pipebenitezpb1/RobotFace/web/img/prueba_mdf.jpg

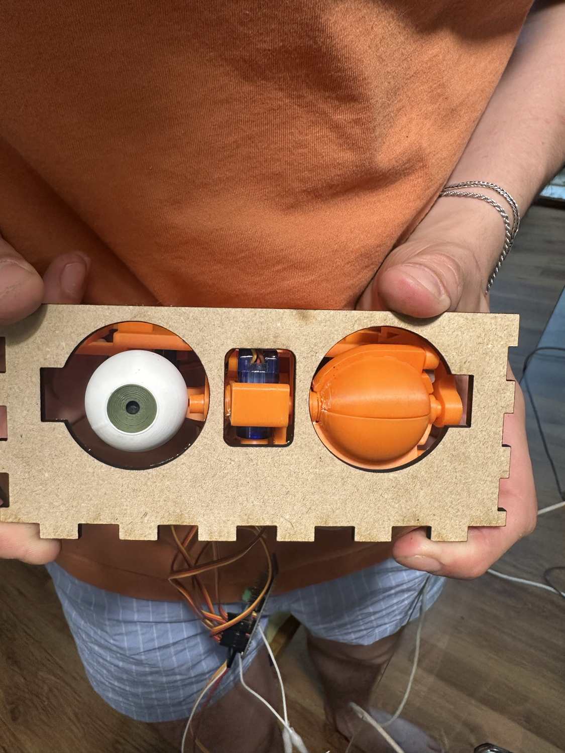
web/img/prueba_mdf.jpg
