pipebenitezpb1/RobotFace/web/img/proceso_prueba_notebook.jpg

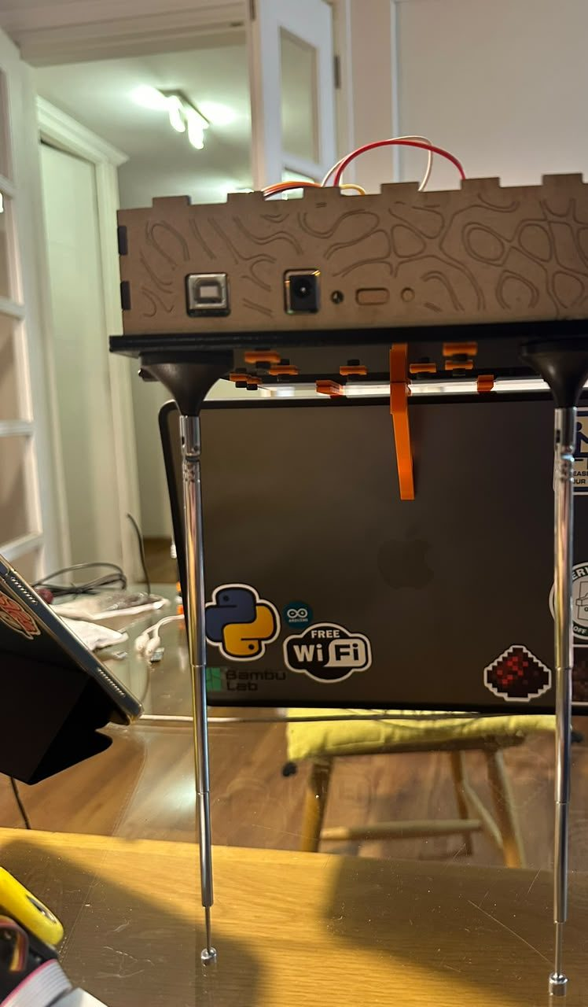
web/img/proceso_prueba_notebook.jpg
