pipebenitezpb1/RobotFace/conocimiento_escuela.ejemplo.md

# Lo que sabe el robot de su escuela (ejemplo)
Copia este archivo como `conocimiento_escuela.md` y completa con información pública del equipo
de tu escuela. hablar.py lo agrega a lo que sabe Claude. No lo subas a internet si trae datos
personales que las personas no publicaron.

## Autoridades
- Nombre Apellido: cargo. Estudios.

## Profesores
- Nombre Apellido: lo que enseña o estudió.
