pipebenitezpb1/RobotFace/cabeza/renders/base_acrilico.png

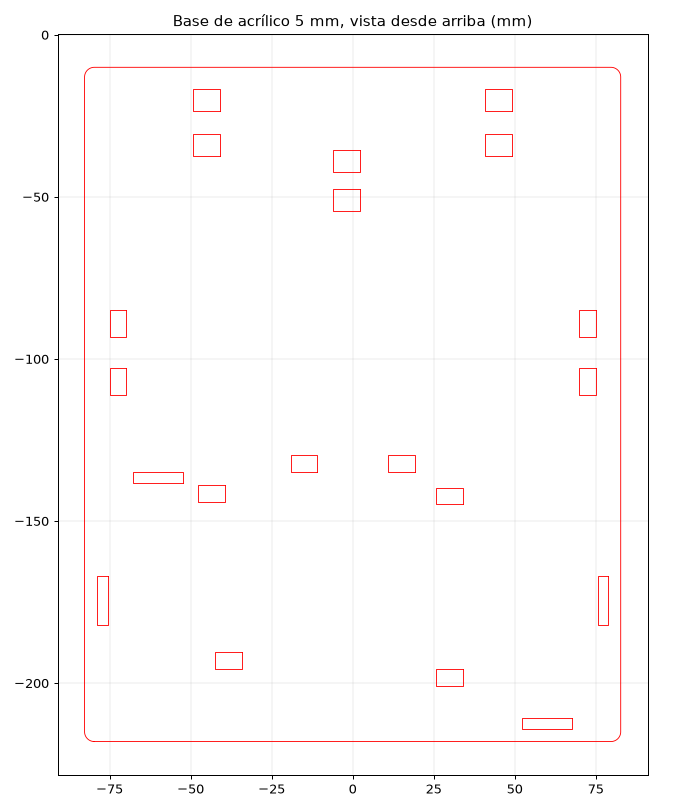
cabeza/renders/base_acrilico.png
