pipebenitezpb1/RobotFace/cabeza/renders/bocas_emociones.png

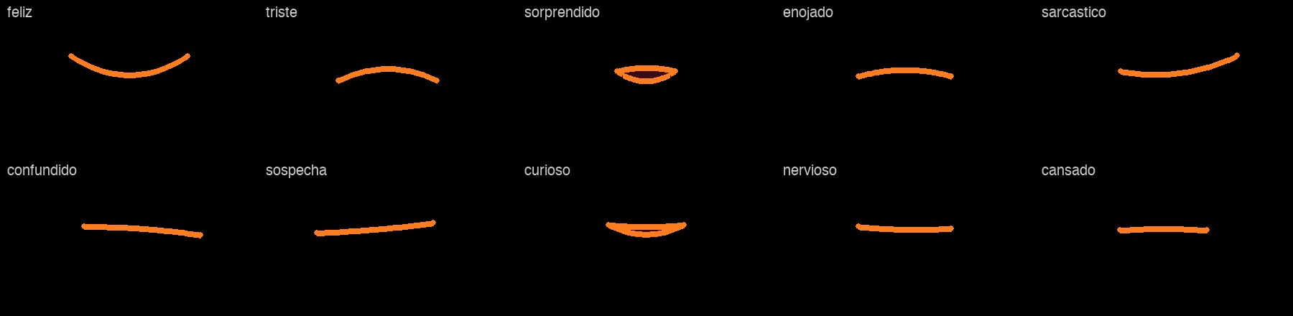
cabeza/renders/bocas_emociones.png
