pipebenitezpb1/RobotFace/cabeza/renders/caja_mdf3.png

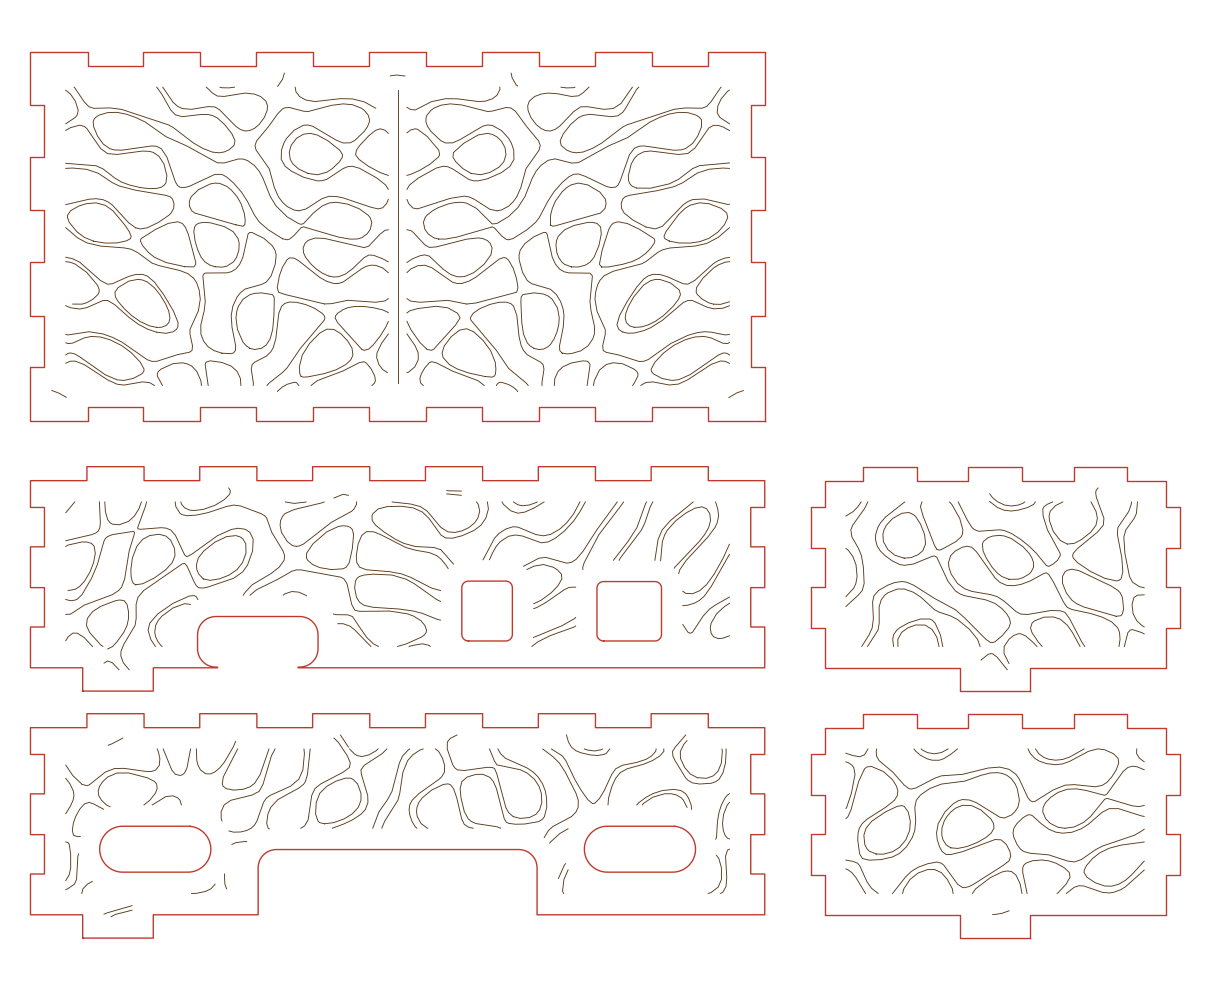
cabeza/renders/caja_mdf3.png
