pipebenitezpb1/RobotFace/cabeza/renders/capsula_usbc.png

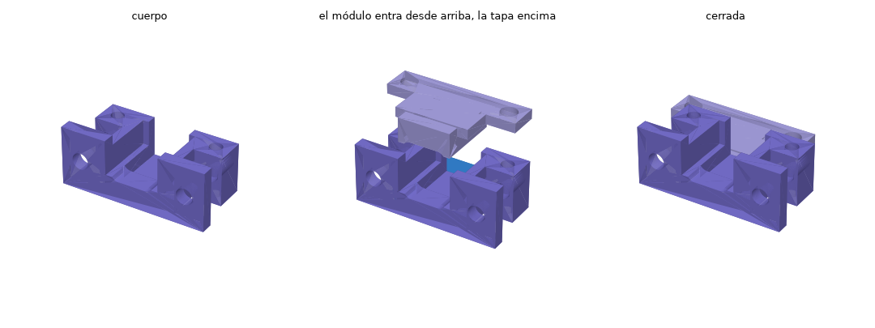
cabeza/renders/capsula_usbc.png
