pipebenitezpb1/RobotFace/cabeza/renders/capsula_usbc_frente.png

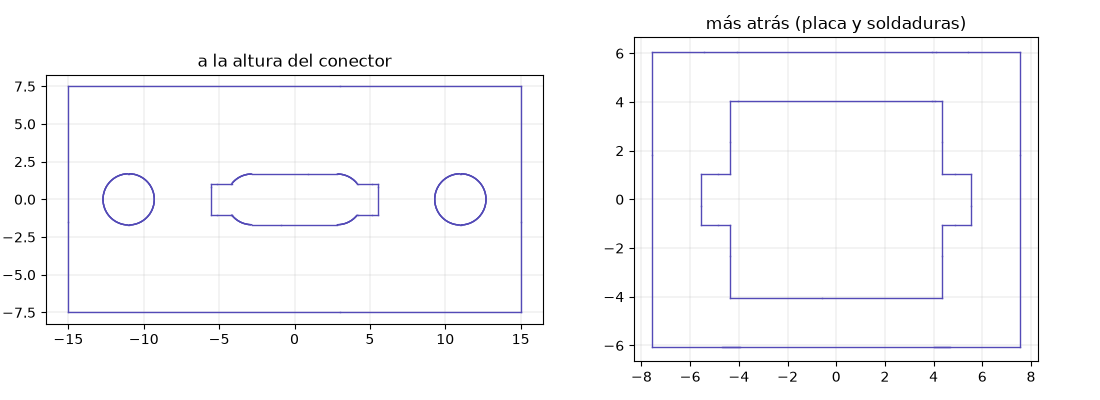
cabeza/renders/capsula_usbc_frente.png
