pipebenitezpb1/RobotFace/cabeza/renders/mapa_ranuras.png

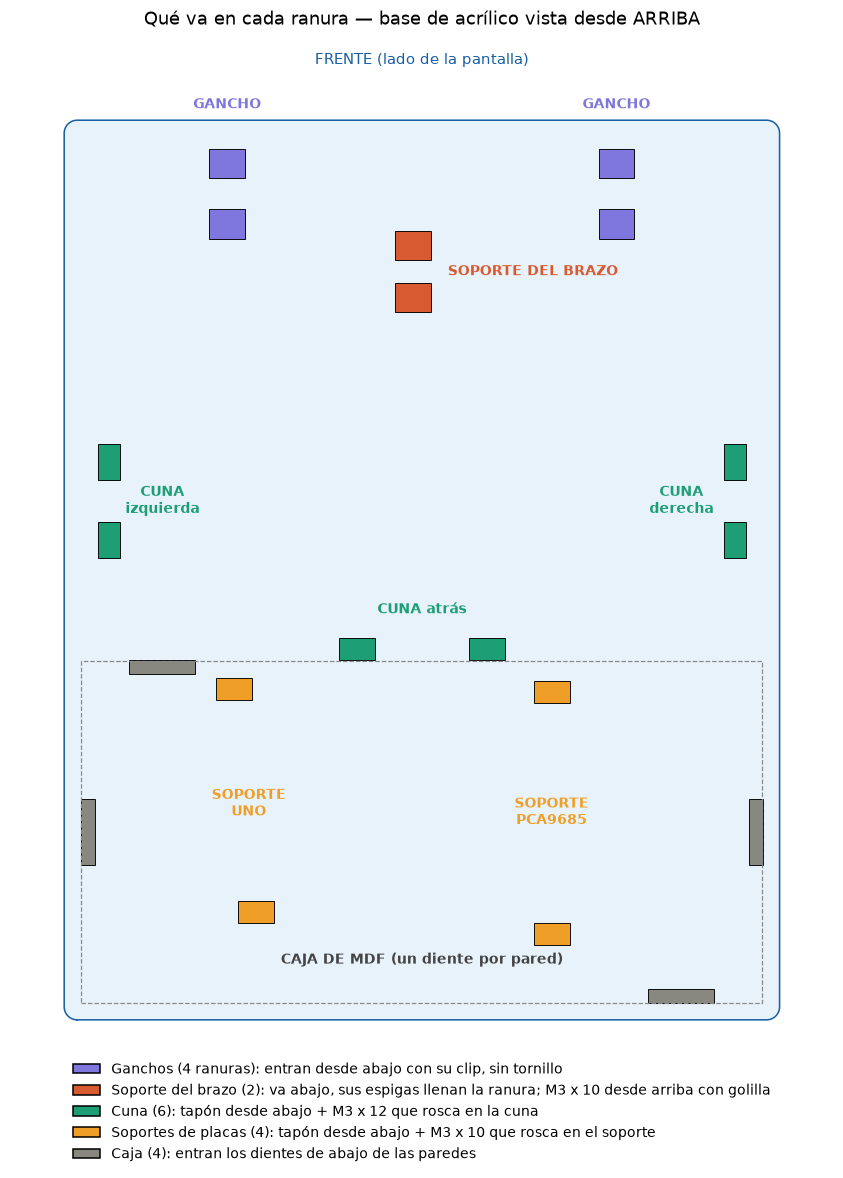
cabeza/renders/mapa_ranuras.png
