pipebenitezpb1/RobotFace/cabeza/renders/pata_lateral.png

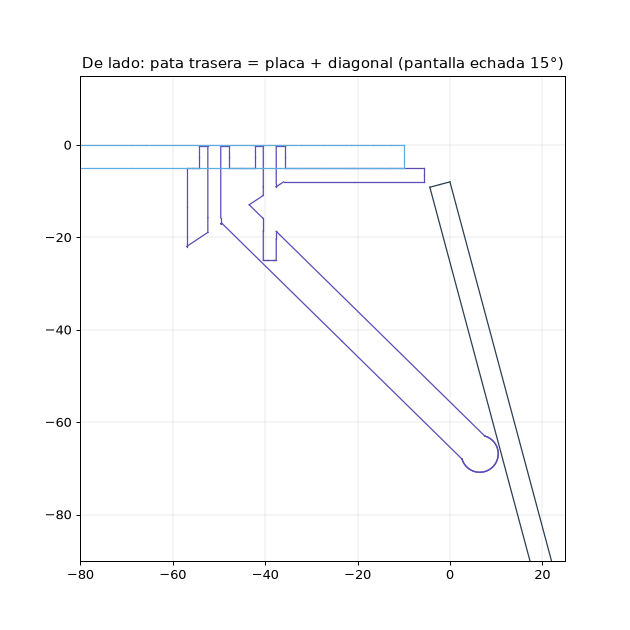
cabeza/renders/pata_lateral.png
