pipebenitezpb1/RobotFace/cabeza/renders/pata_mesa.png

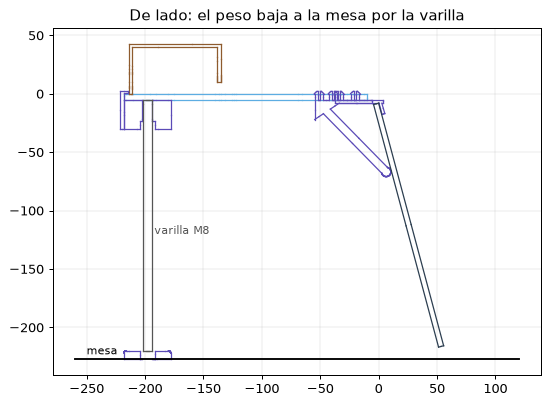
cabeza/renders/pata_mesa.png
