pipebenitezpb1/RobotFace/cabeza/renders/soporte_uno.png

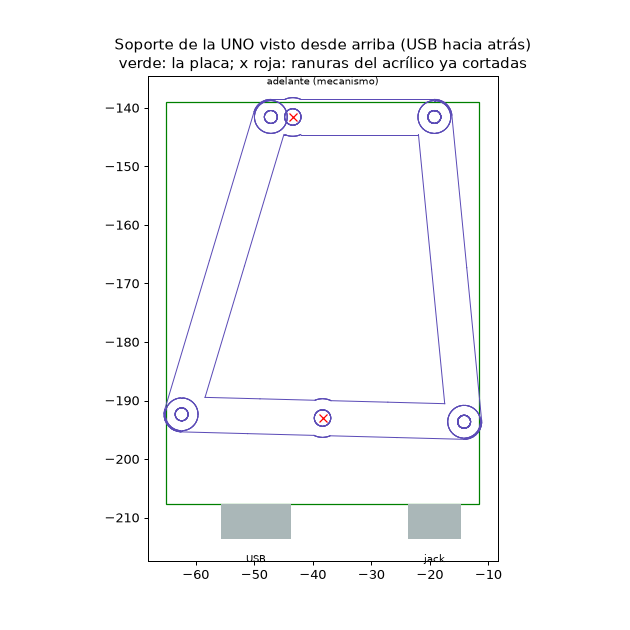
cabeza/renders/soporte_uno.png
