pipebenitezpb1/RobotFace/cabeza/renders/vista.png

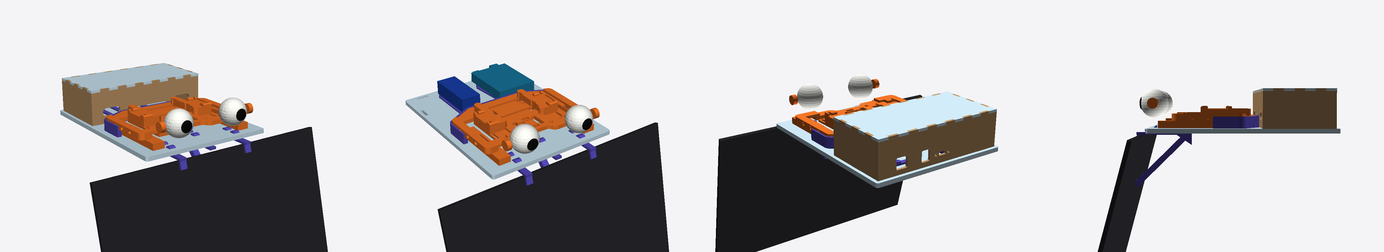
cabeza/renders/vista.png
