pipebenitezpb1/RobotFace/web/img/arriba.jpg

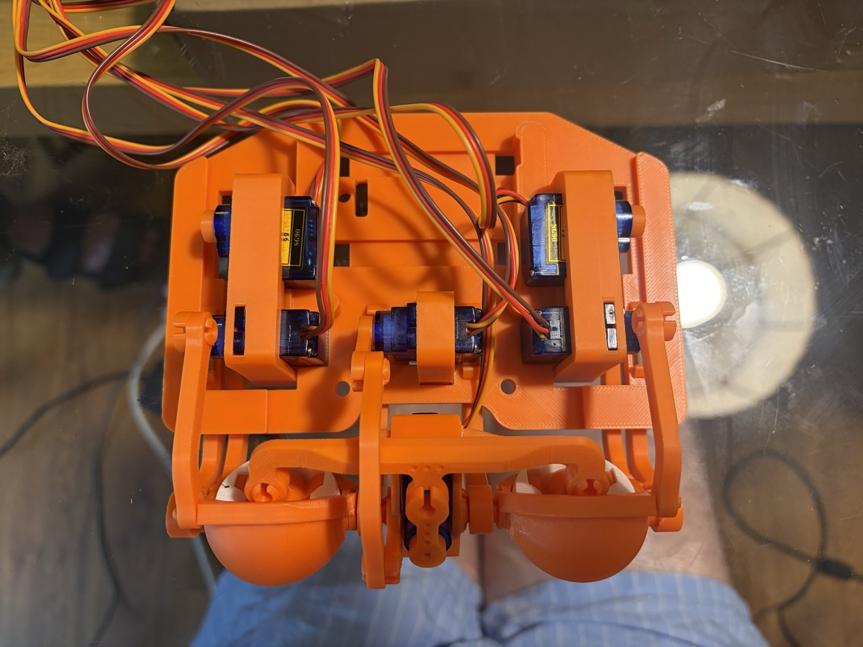
web/img/arriba.jpg
