pipebenitezpb1/RobotFace/web/img/atras.jpg

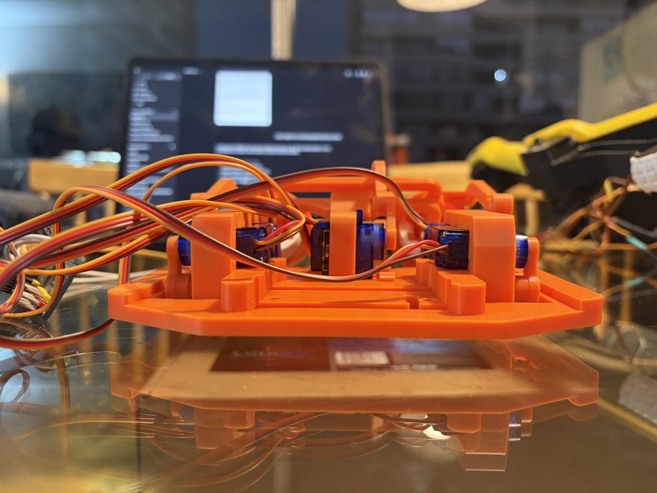
web/img/atras.jpg
