pipebenitezpb1/RobotFace/web/img/base.jpg

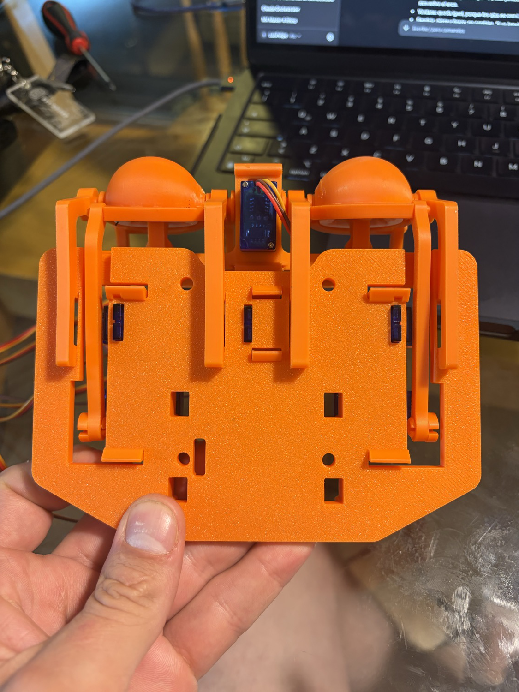
web/img/base.jpg
