pipebenitezpb1/RobotFace/web/img/boceto.jpg

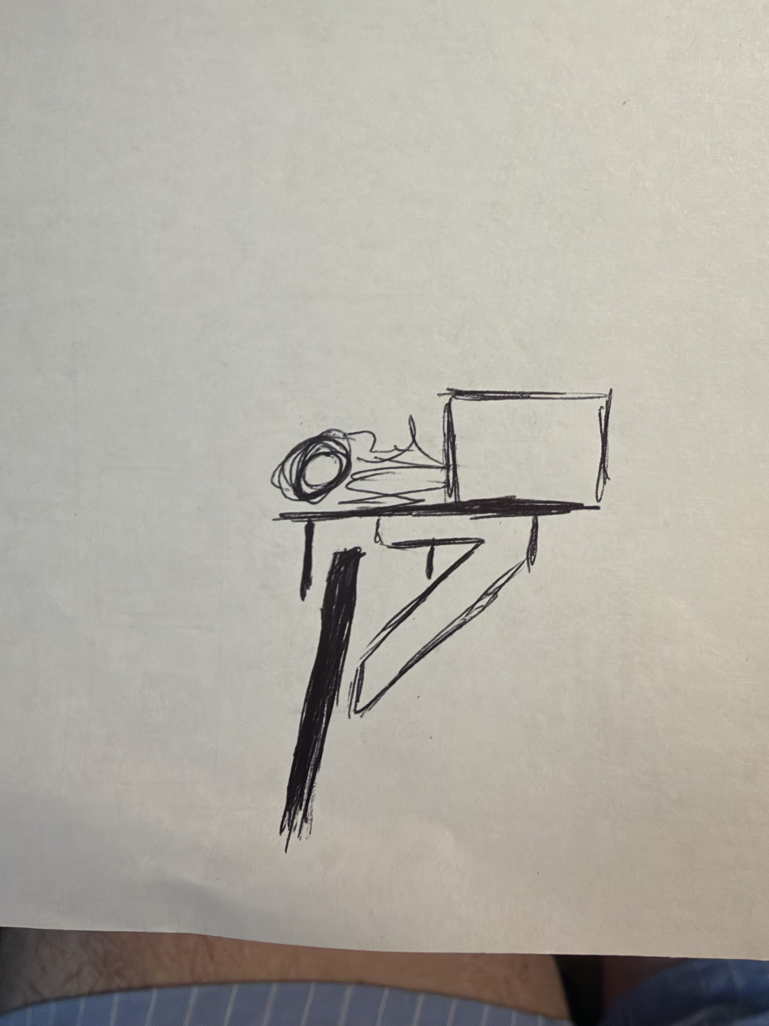
web/img/boceto.jpg
