pipebenitezpb1/RobotFace/web/img/estudio_arriba.jpg

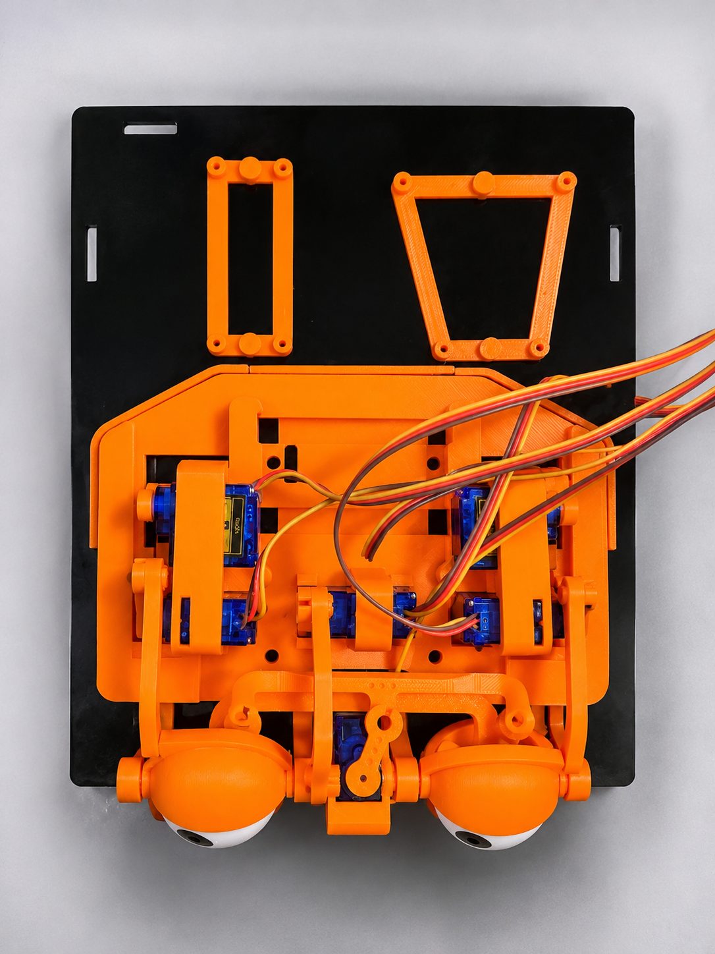
web/img/estudio_arriba.jpg
