pipebenitezpb1/RobotFace/web/img/estudio_arriba_arduino.jpg

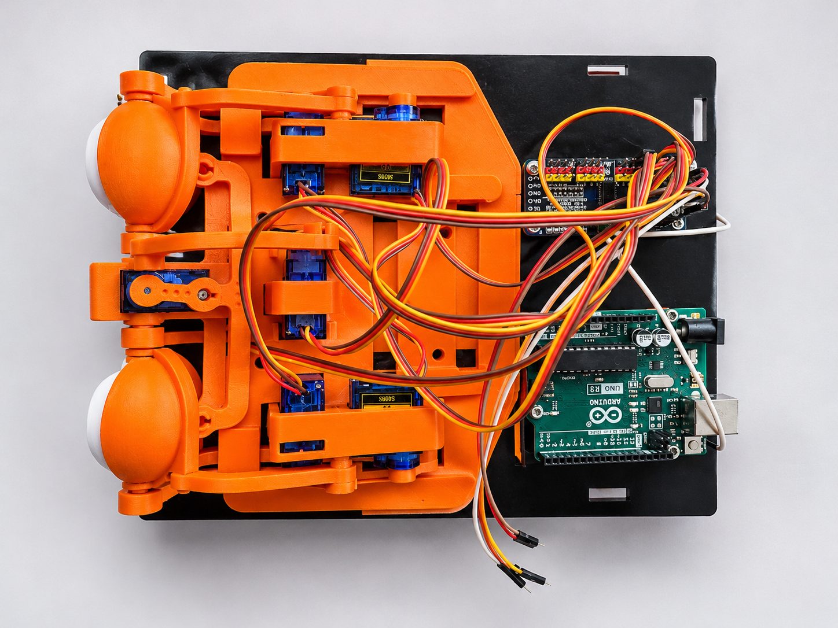
web/img/estudio_arriba_arduino.jpg
