pipebenitezpb1/RobotFace/web/img/estudio_frente_mdf.jpg

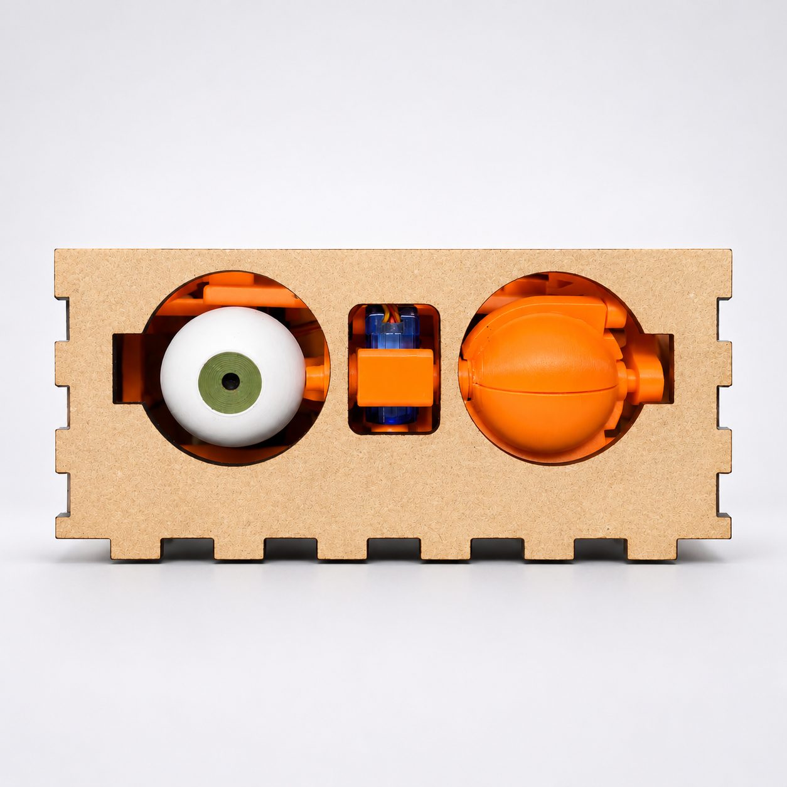
web/img/estudio_frente_mdf.jpg
