pipebenitezpb1/RobotFace/web/img/estudio_lado.jpg

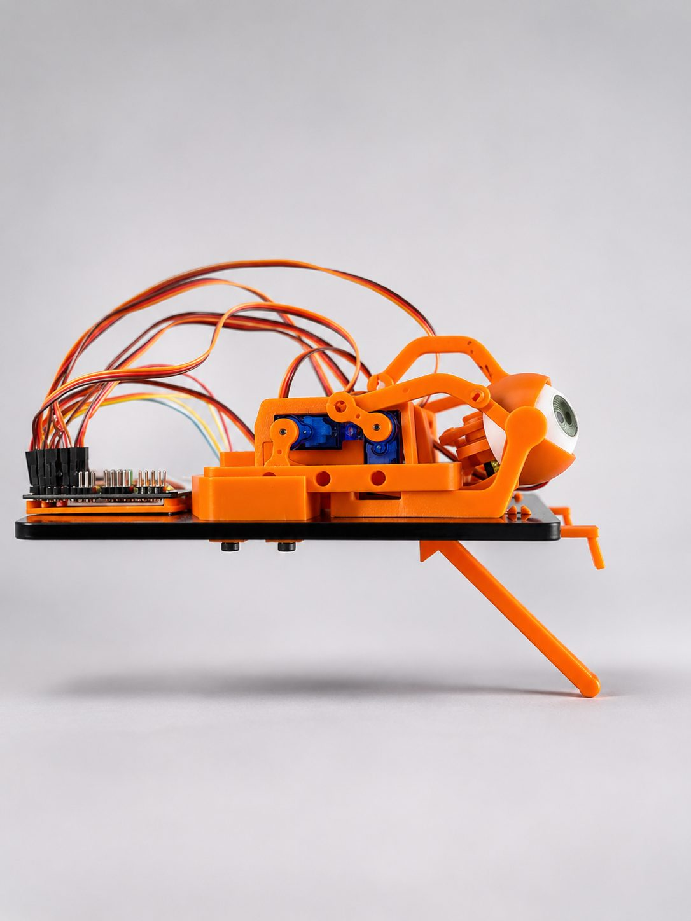
web/img/estudio_lado.jpg
