pipebenitezpb1/RobotFace/web/img/estudio_mecanismo.jpg

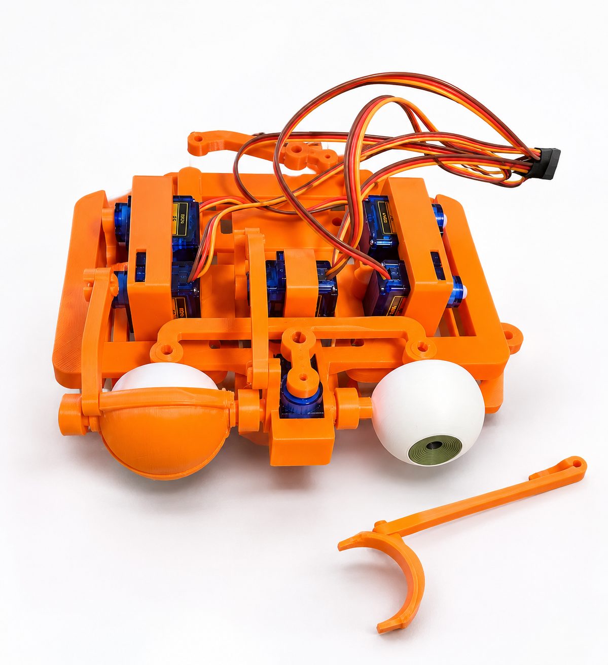
web/img/estudio_mecanismo.jpg
