pipebenitezpb1/RobotFace/web/img/estudio_tres_cuartos.jpg

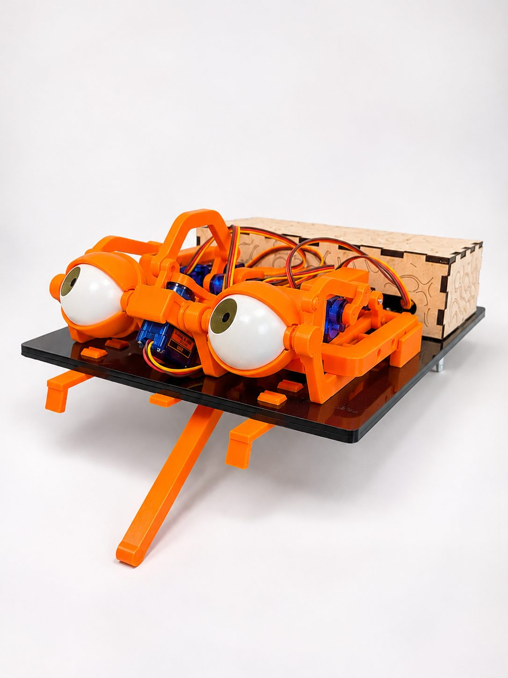
web/img/estudio_tres_cuartos.jpg
