pipebenitezpb1/RobotFace/web/img/frente.jpg

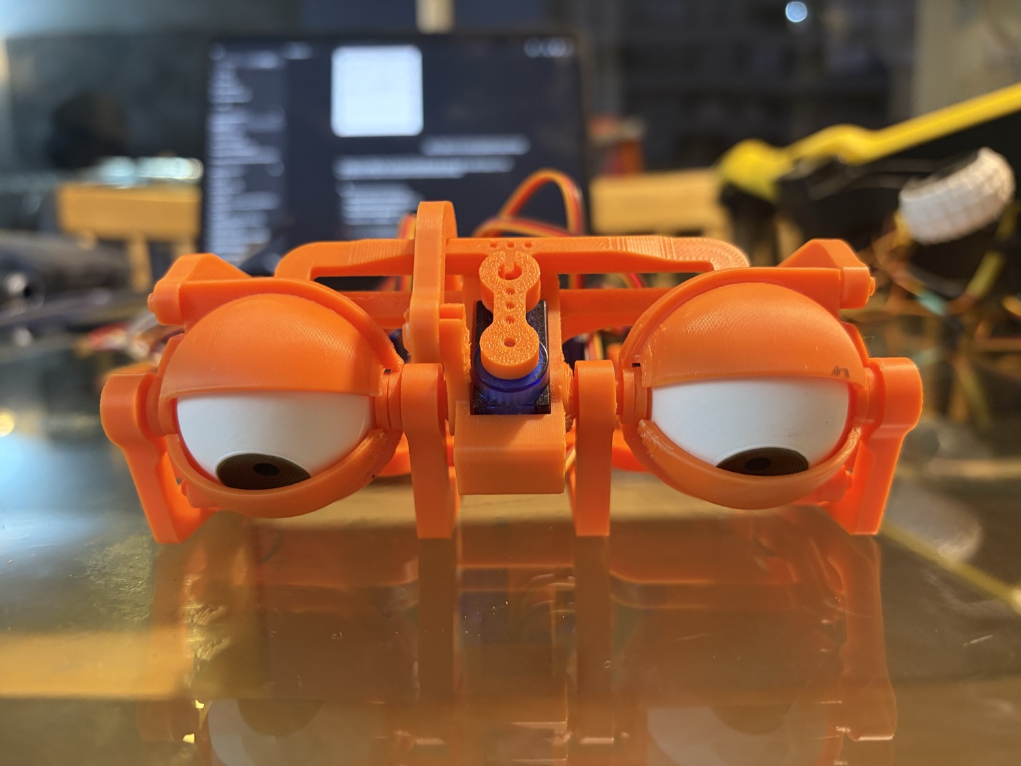
web/img/frente.jpg
