pipebenitezpb1/RobotFace/web/img/lado.jpg

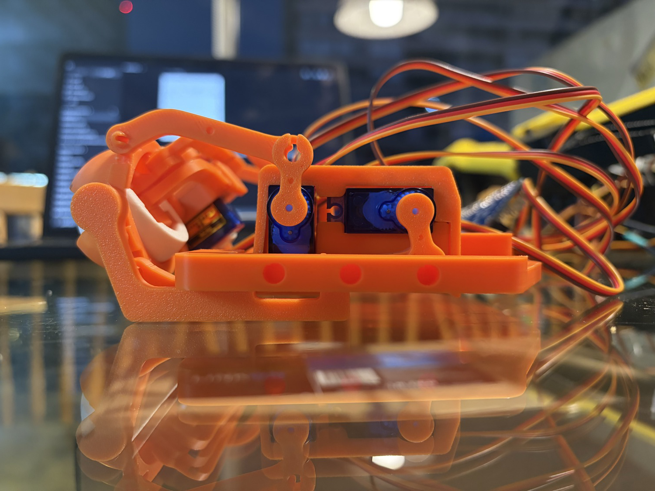
web/img/lado.jpg
