pipebenitezpb1/RobotFace/web/img/proceso_caja_abierta.jpg

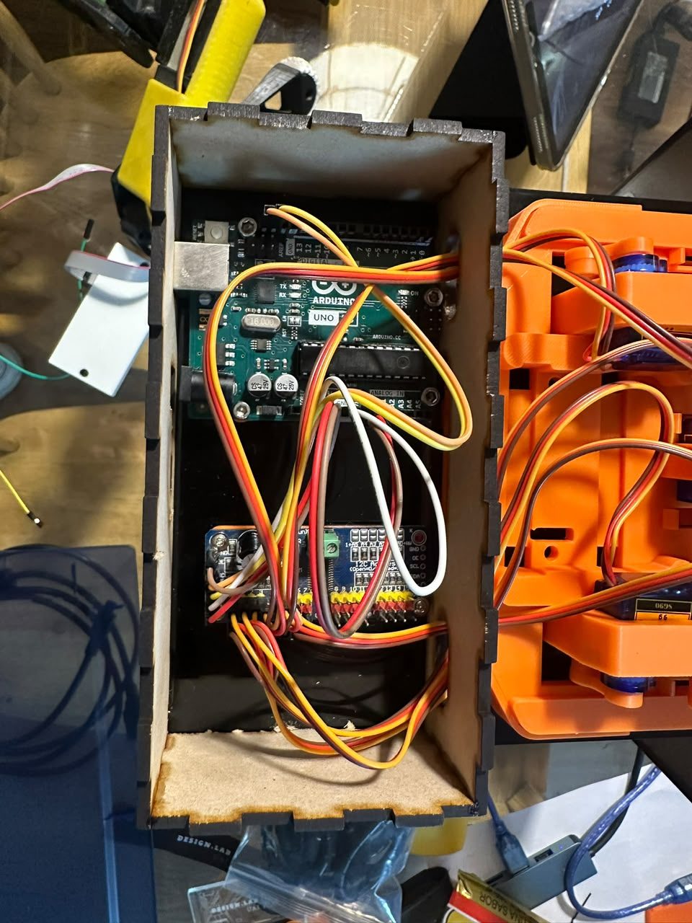
web/img/proceso_caja_abierta.jpg
