pipebenitezpb1/RobotFace/web/img/proceso_caja_cerebro.jpg

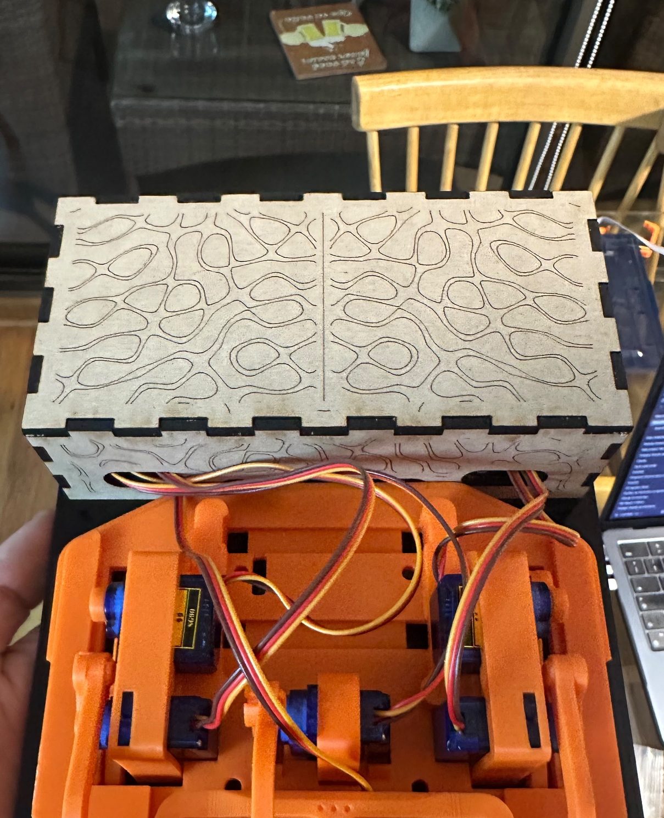
web/img/proceso_caja_cerebro.jpg
