pipebenitezpb1/RobotFace/web/img/proceso_electronica.jpg

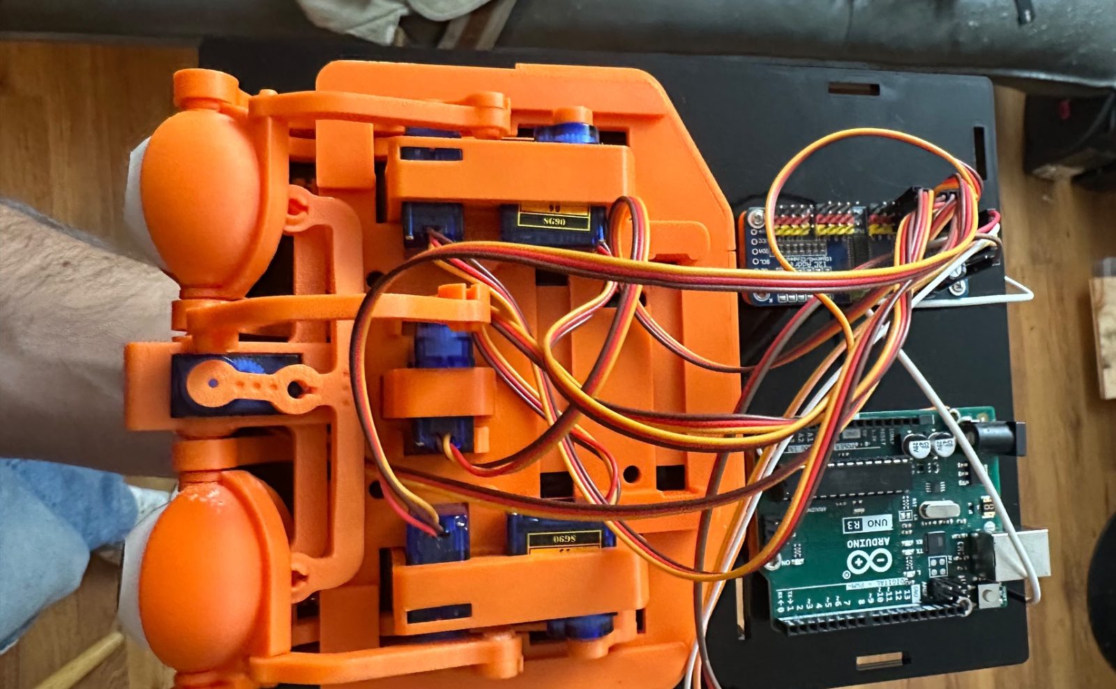
web/img/proceso_electronica.jpg
