pipebenitezpb1/RobotFace/web/img/proceso_frente.jpg

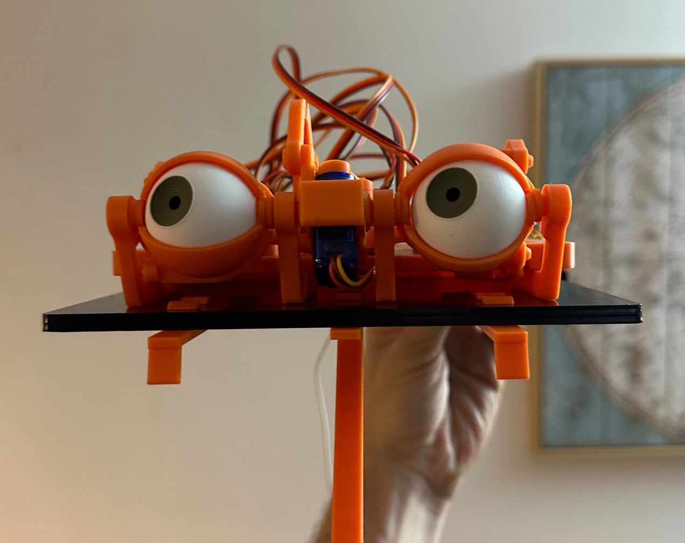
web/img/proceso_frente.jpg
