pipebenitezpb1/RobotFace/web/img/proceso_lado.jpg

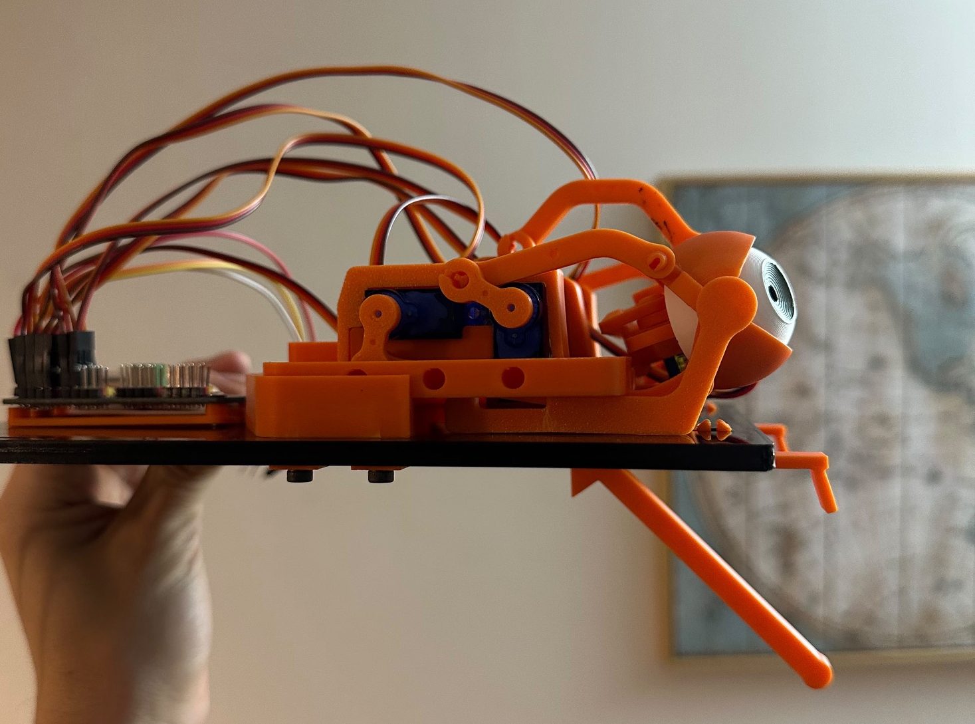
web/img/proceso_lado.jpg
