pipebenitezpb1/RobotFace/web/img/proceso_soportes.jpg

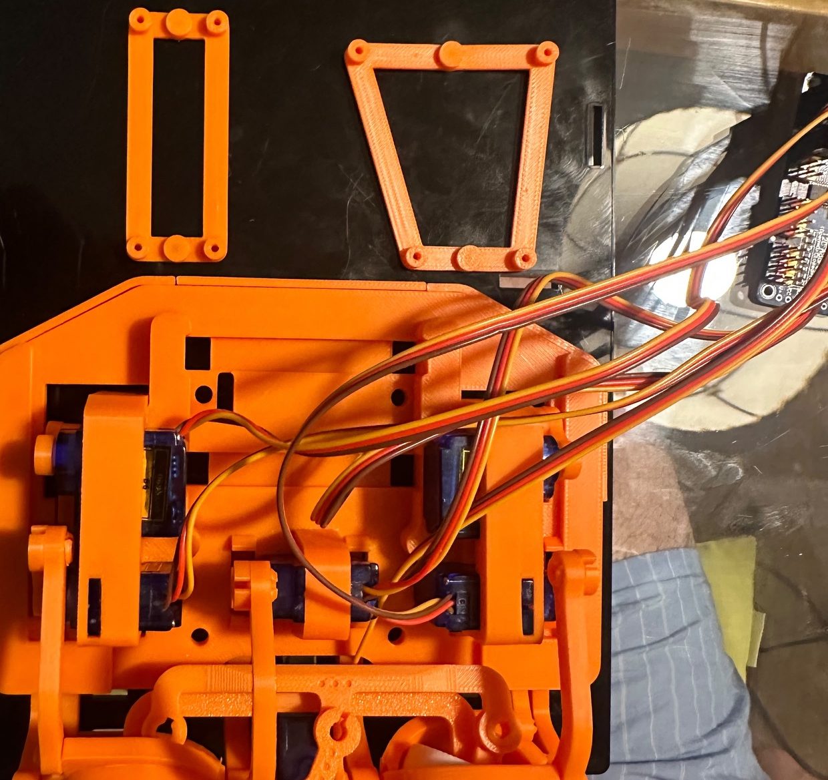
web/img/proceso_soportes.jpg
