pipebenitezpb1/RobotFace/cabeza/referencia/caja_electronica_armada.stl

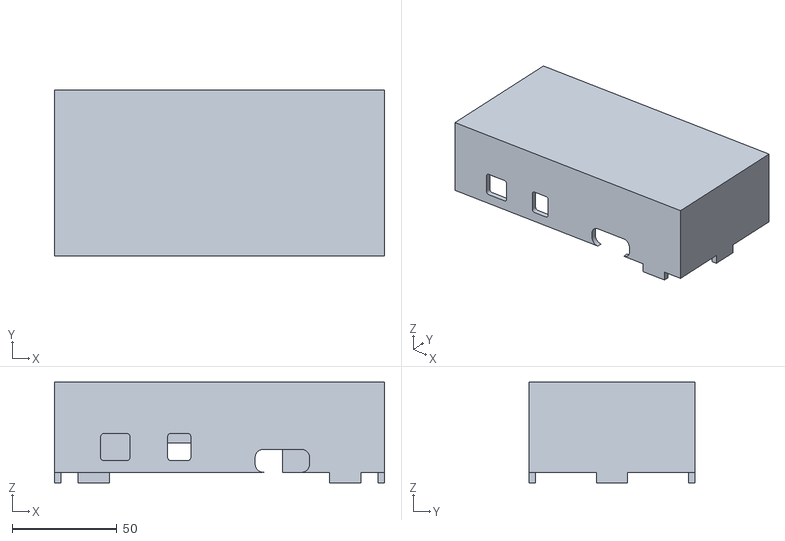
[picture p31: CAD file, 2026-11-06]
cabeza/referencia/caja_electronica_armada.stl
157.4 x 79.0 x 48.0
