pipebenitezpb1/RobotFace/cabeza/stl_base/pie_mesa.stl

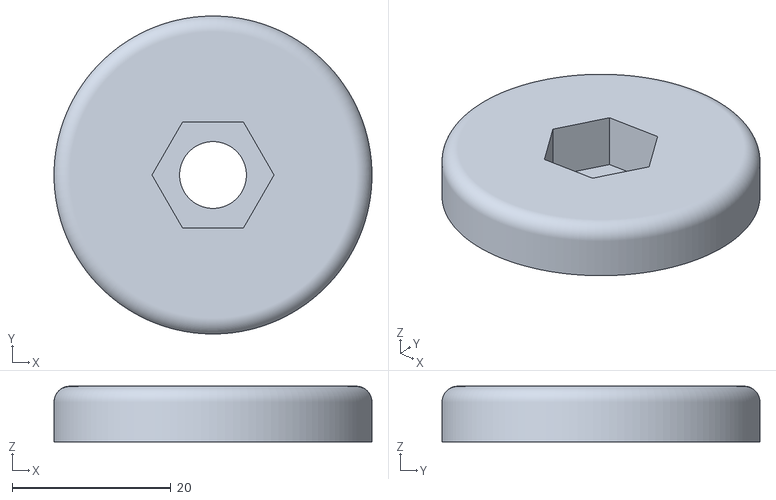
[picture p32: CAD file, 2026-11-06]
cabeza/stl_base/pie_mesa.stl
40.0 x 40.0 x 7.00
