pipebenitezpb1/RobotFace/cabeza/stl_base/soporte_pca.stl

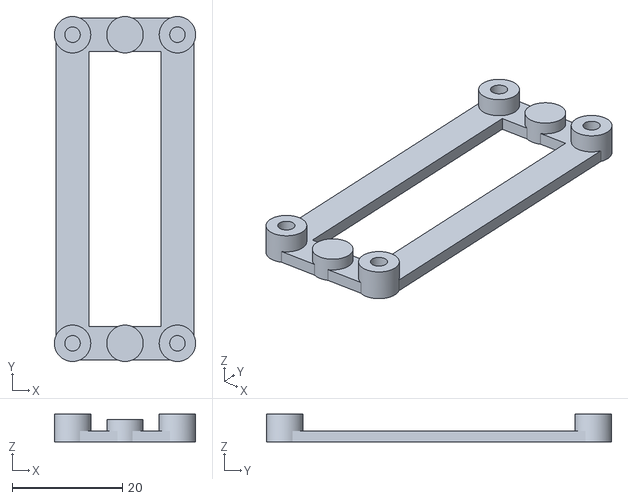
[picture p33: CAD file, 2026-11-06]
cabeza/stl_base/soporte_pca.stl
25.6 x 62.5 x 5.00
