pipebenitezpb1/RobotFace/cabeza/stl_base/tapon.stl

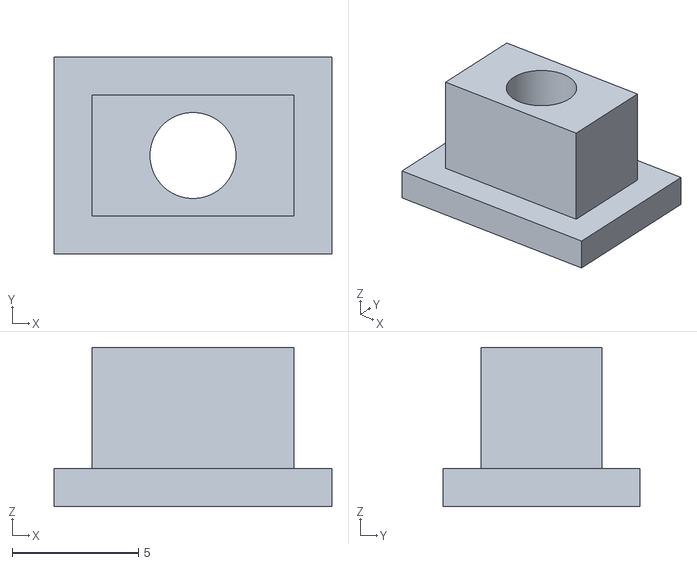
[picture p34: CAD file, 2026-11-06]
cabeza/stl_base/tapon.stl
11.0 x 7.80 x 6.30
