pipebenitezpb1/RobotFace/cabeza/stl_base/cuna_derecha.stl

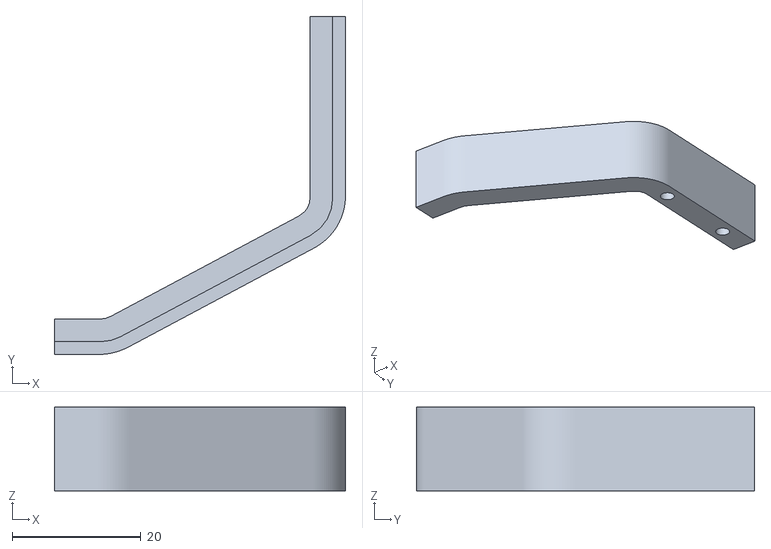
[picture p35: CAD file, 2026-11-06]
cabeza/stl_base/cuna_derecha.stl
45.2 x 52.5 x 13.0
