pipebenitezpb1/RobotFace/cabeza/stl_base/cuna_atras.stl

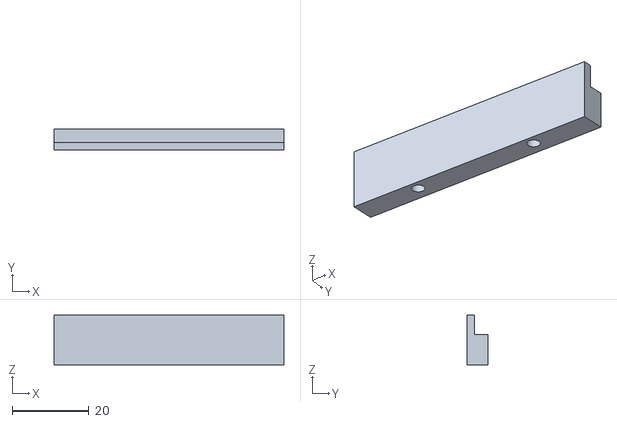
[picture p36: CAD file, 2026-11-06]
cabeza/stl_base/cuna_atras.stl
60.0 x 5.56 x 13.0
