pipebenitezpb1/RobotFace/cabeza/stl_base/pata_trasera.stl

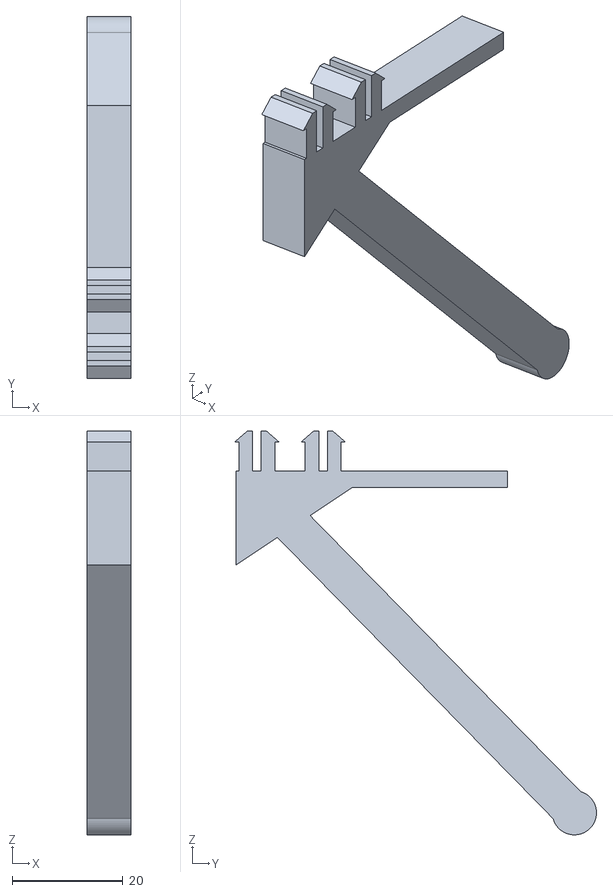
[picture p37: CAD file, 2026-11-06]
cabeza/stl_base/pata_trasera.stl
8.00 x 65.5 x 73.1
