pipebenitezpb1/RobotFace/cabeza/stl_base/gancho.stl

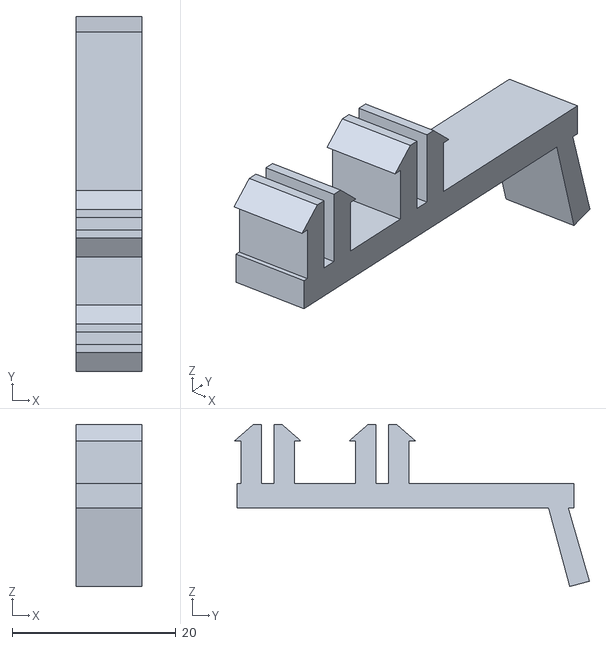
[picture p38: CAD file, 2026-11-06]
cabeza/stl_base/gancho.stl
8.00 x 43.3 x 19.8
