pipebenitezpb1/RobotFace/cabeza/stl_base/soporte_uno.stl

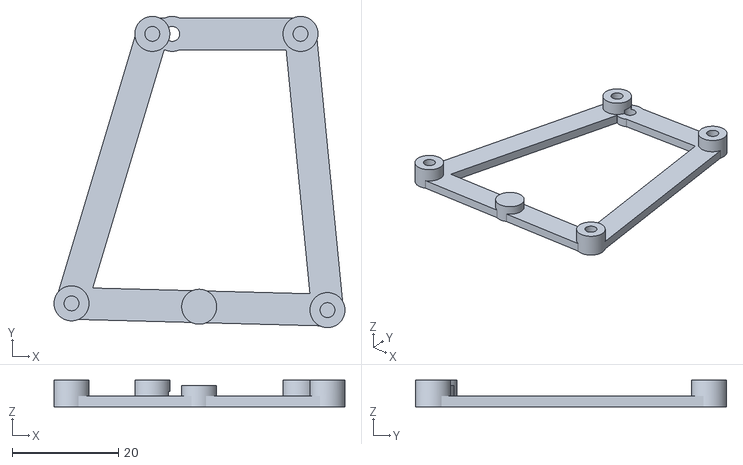
[picture p39: CAD file, 2026-11-06]
cabeza/stl_base/soporte_uno.stl
54.9 x 58.7 x 5.00
