pipebenitezpb1/RobotFace/cabeza/stl_base/capsula_usbc_cuerpo.stl

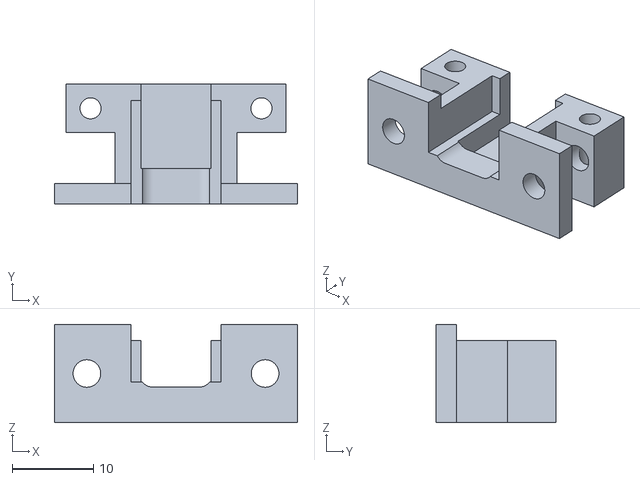
[picture p40: CAD file, 2026-11-06]
cabeza/stl_base/capsula_usbc_cuerpo.stl
30.0 x 14.8 x 12.1
