pipebenitezpb1/RobotFace/cabeza/stl_base/abrazadera_mesa.stl

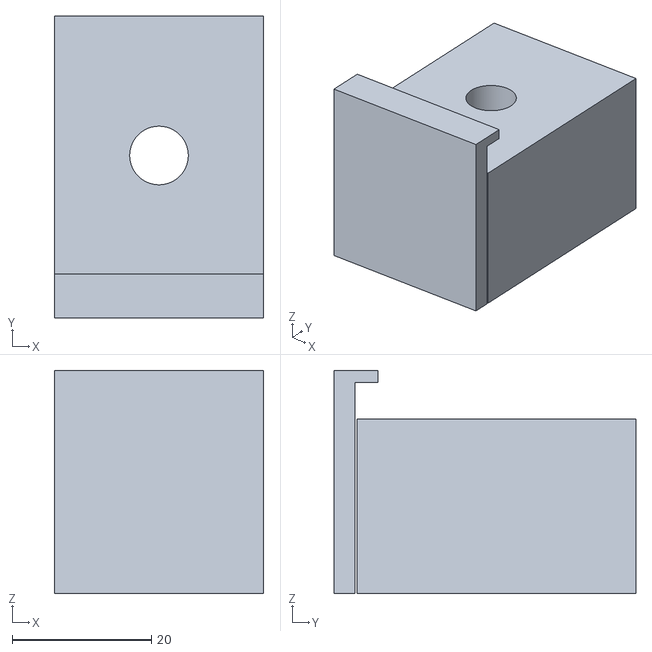
[picture p41: CAD file, 2026-11-06]
cabeza/stl_base/abrazadera_mesa.stl
30.0 x 43.3 x 32.0
