pipebenitezpb1/RobotFace/cabeza/stl_base/capsula_usbc_tapa.stl

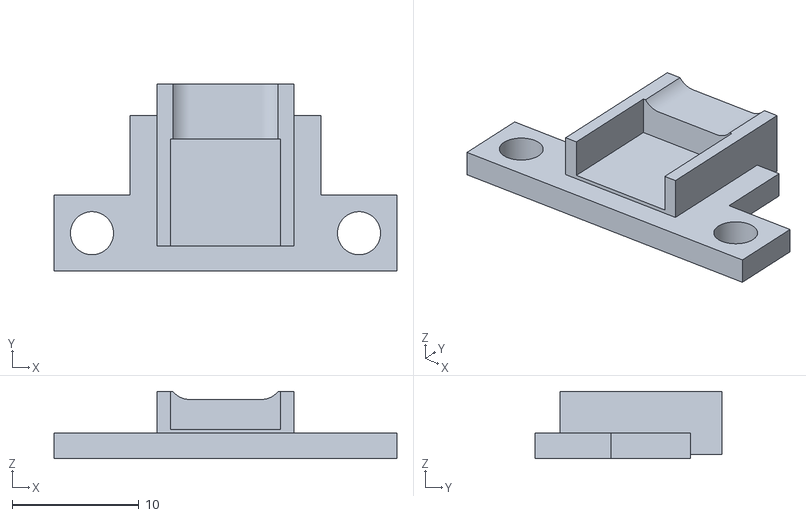
[picture p42: CAD file, 2026-11-06]
cabeza/stl_base/capsula_usbc_tapa.stl
27.1 x 14.8 x 5.30
