pipebenitezpb1/RobotFace/(list of files, cad)

Other CAD files:
cabeza/stl_base/cuna_izquierda.stl
